gbergiel/BIOSTRAT2/LAB_ON_CHIP_MAIN.stl

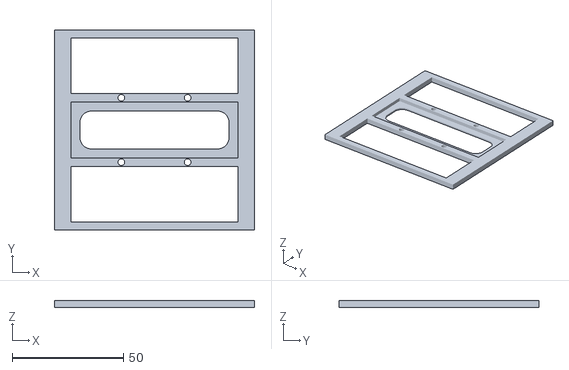
[picture p20: CAD file, 2024-11-25]
LAB_ON_CHIP_MAIN.stl
90.0 x 90.0 x 3.00
