gbergiel/BIOSTRAT2/main_cpu.stl

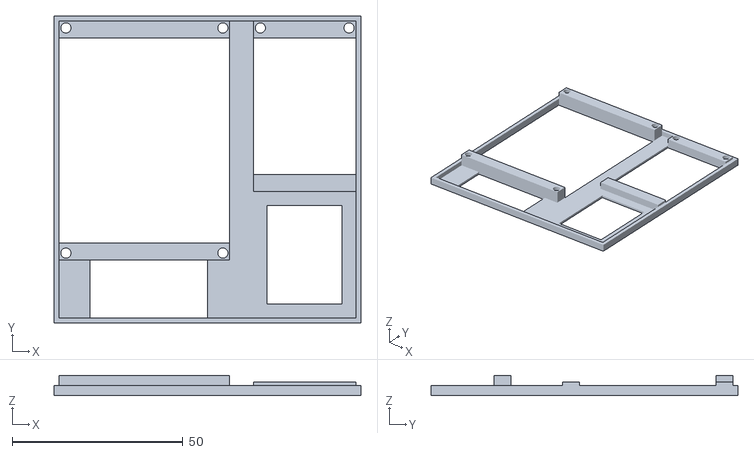
[picture p21: CAD file, 2024-11-25]
main_cpu.stl
90.0 x 90.0 x 6.00
