gbergiel/BIOSTRAT2/BAR_LAB_ON_CHIP.stl

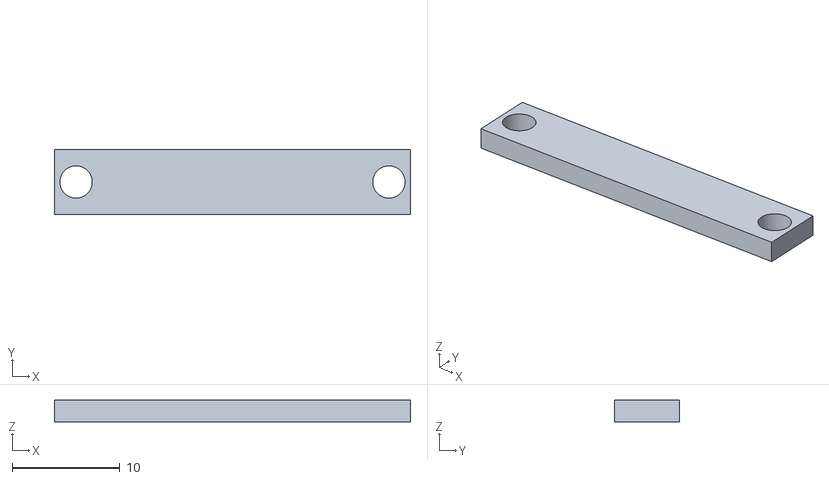
[picture p22: CAD file, 2024-11-25]
BAR_LAB_ON_CHIP.stl
33.0 x 6.00 x 2.00
